AkBKukU/ATX2PCjr/README.md

# ATX to PCjr

An ATX to IBM PCjr adapter board

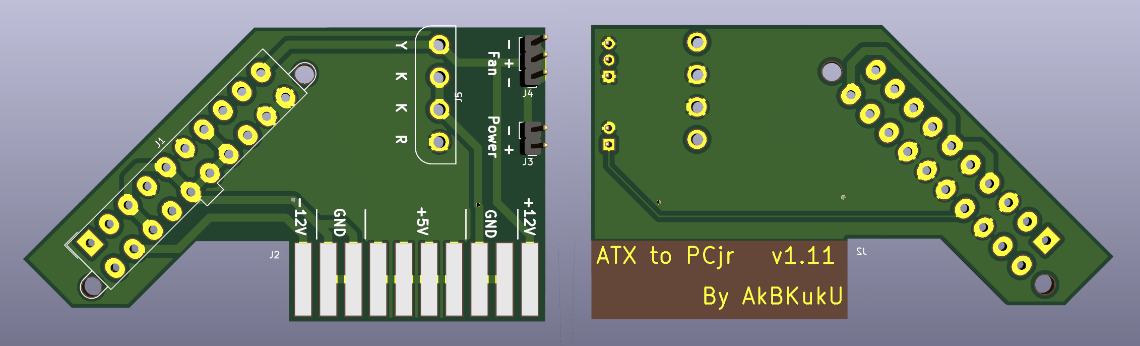
[picture p1: doc/board.jpg]
A 3d render of the adapter board The adapter PCB


This allows you to use a standard ATX power supply to power an IBM PC jr.
