AkBKukU/ATX2PCjr/cad/rearPanel/panelBarrel.stl

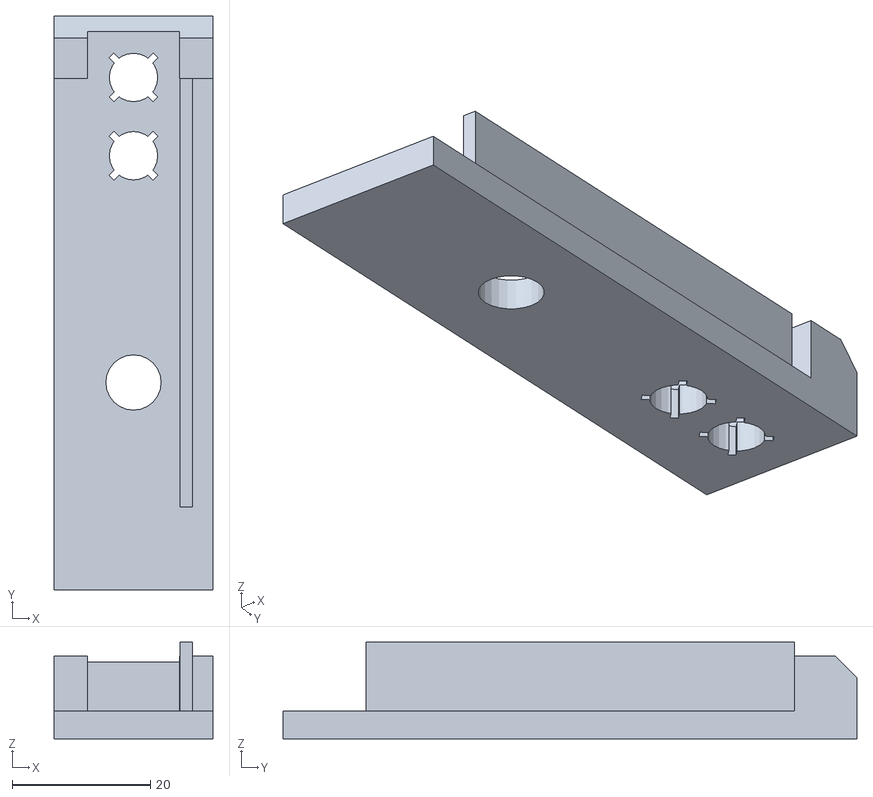
[picture p2: CAD file, 2019-08-21]
cad/rearPanel/panelBarrel.stl
23.0 x 83.0 x 14.0
