AkBKukU/ATX2PCjr/cad/rearPanel/panelATX.stl

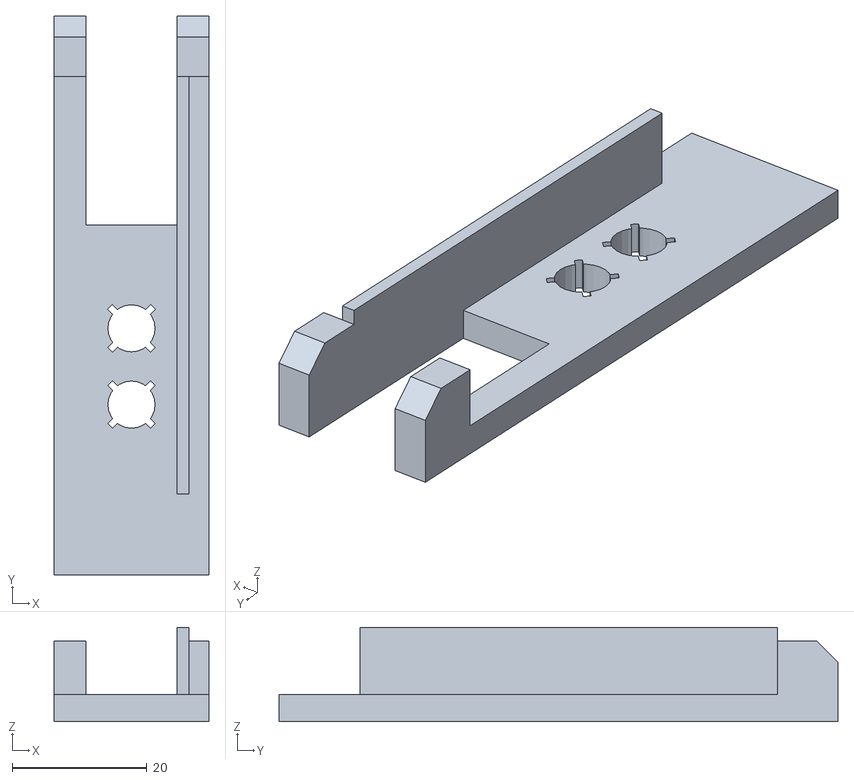
[picture p3: CAD file, 2019-08-21]
cad/rearPanel/panelATX.stl
23.0 x 83.0 x 14.0
