AkBKukU/ATX2PCjr/doc/top.pdf

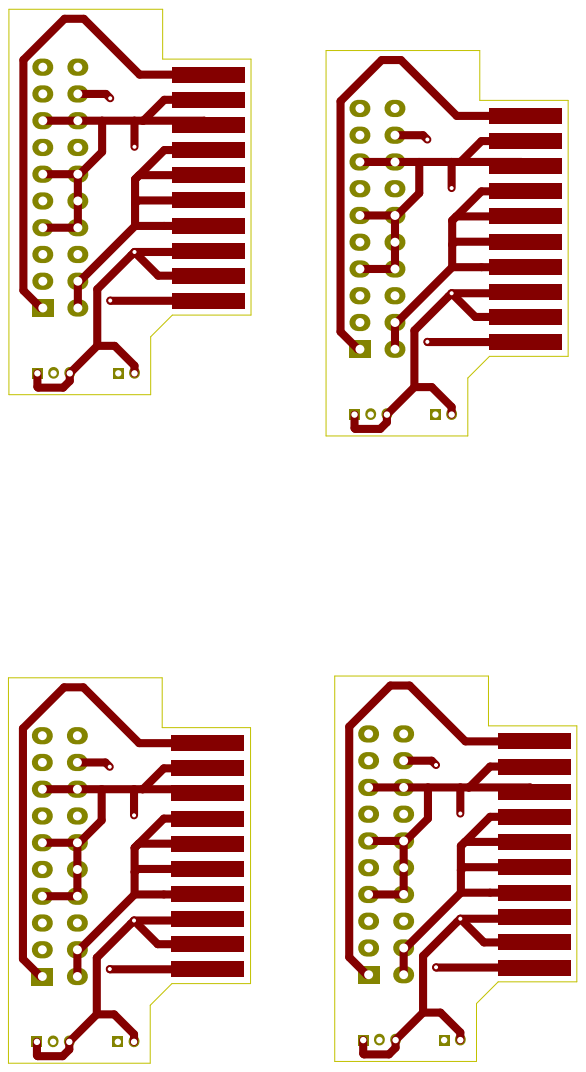
[picture p4: page 1]
