AkBKukU/ATX2PCjr/eda/ATX2PCjr/ATX2PCjr.kicad_pcb

## KiCad design eda/ATX2PCjr/ATX2PCjr.kicad_pcb (2018-11-10)

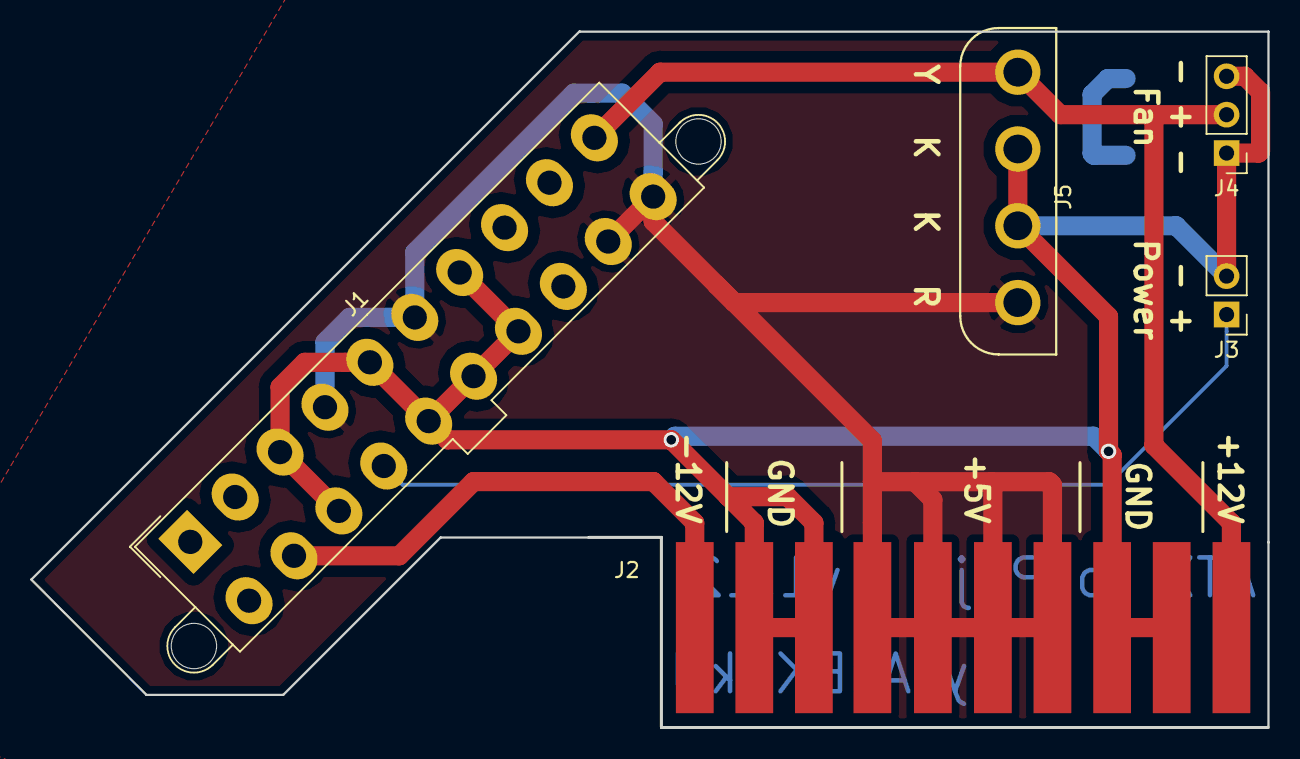
[picture p5: board ATX2PCjr.kicad_pcb from above]

Board: 2 copper layers, 81.8 x 46.1 mm, 5 parts (0 on the bottom side), 5 nets.

Parts:
J1: ATX Connector; Molex_Mini-Fit_Jr_5566-20A2_2x10_P4.20mm_Vertical-LARGE
J2: PCjr Card Edge; PCjr Power Board Card Edge
J3: Power Switch Header; PinHeader_1x02_P2.54mm_Vertical
J4: Fan Header; PinHeader_1x03_P2.54mm_Vertical
J5: Floppy Power; Mate-N-Lok Vertical

Connections:
/+5V: J1.4, J1.6, J1.19, J1.20, J2.4, J2.5, J2.6, J2.7, J5.1
/+12V: J1.10, J2.10, J4.2, J5.4
/-12V: J1.12, J2.1
/GND: J1.3, J1.5, J1.7, J1.13, J1.15, J1.16, J1.17, J2.2, J2.3, J2.8, J2.9, J3.2, J4.1, J4.3, J5.2, J5.3
/PS-ON: J1.14, J3.1
