AkBKukU/ATX2PCjr/(commit log)

2018-08-11 Restructure and start panel
    [ATX2PCjr.kicad_pcb, ATX2PCjr.sch, PCjrRearPanel.kicad_pcb, PCjrRearPanel.sch]
2018-08-12 Switch to 3d printed panel
    [PCjrRearPanel.kicad_pcb, PCjrRearPanel.sch, panel.scad, panel.stl]
2018-08-12 Board version 1.1
    [ATX2PCjr-B.Cu.gbr, ATX2PCjr-B.Mask.gbr, ATX2PCjr-B.Paste.gbr, ATX2PCjr-B.SilkS.gbr, ATX2PCjr-Edge.Cuts.gbr, ATX2PCjr-F.Cu.gbr, ATX2PCjr-F.Mask.gbr, ATX2PCjr-F.Paste.gbr]
2018-08-17 Update rear panel with bevel and slot option
    [ATX2PCjr.kicad_pcb, panel.scad]
2018-08-30 top switch
    [panel.scad, panelBarrel.stl]
2018-09-06 update panel(s)
    [panel.scad, panelATX.stl, panelBarrel.stl]
2018-09-06 Updated to v1.11 to fix minor issues
    [ATX2PCjr-B.Cu.gbr, ATX2PCjr-B.Mask.gbr, ATX2PCjr-B.Paste.gbr, ATX2PCjr-B.SilkS.gbr, ATX2PCjr-Edge.Cuts.gbr, ATX2PCjr-F.Cu.gbr, ATX2PCjr-F.Mask.gbr, ATX2PCjr-F.Paste.gbr]
2018-11-10 MiniFit Jr Vias and Panel Holes
    [ATX2PCjr-B.Cu.gbr, ATX2PCjr-B.Mask.gbr, ATX2PCjr-B.Paste.gbr, ATX2PCjr-B.SilkS.gbr, ATX2PCjr-Edge.Cuts.gbr, ATX2PCjr-F.Cu.gbr, ATX2PCjr-F.Mask.gbr, ATX2PCjr-F.Paste.gbr]
2019-08-16 Switch change and reset
    [panel.scad, panelATX.stl, panelBarrel.stl]
2019-08-20 hole size fitment
    [panel.scad, panelATX.stl, panelBarrel.stl]
2019-08-21 Size tweak
    [panel.scad, panelATX.stl, panelBarrel.stl]
2019-08-22 Notes printout
